Rodrigodp97/IOT01/PCB/WhatsApp Image 2025-04-30 at 15.31.54.jpeg

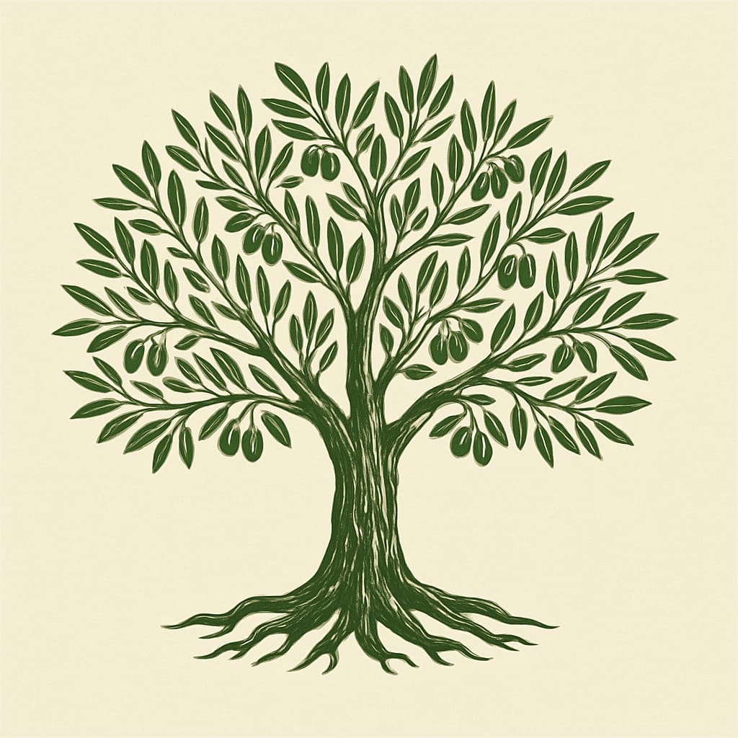
PCB/WhatsApp Image 2025-04-30 at 15.31.54.jpeg
