Rodrigodp97/IOT01/PCB/WhatsApp Image 2025-04-29 at 13.22.06.jpeg

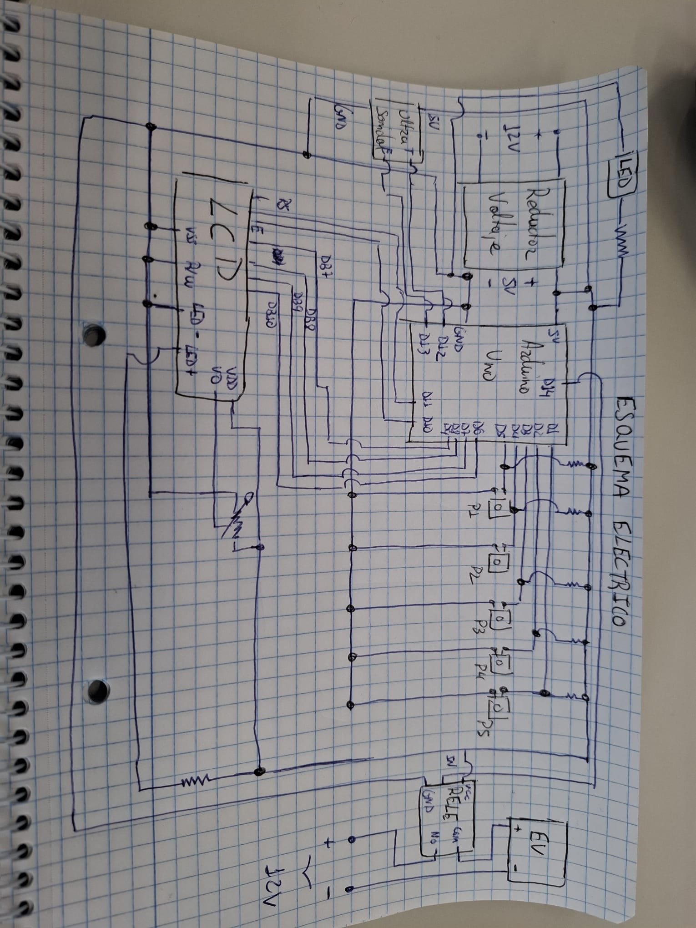
PCB/WhatsApp Image 2025-04-29 at 13.22.06.jpeg
