Rodrigodp97/IOT01/GUI/assets/images/93916a4476.png

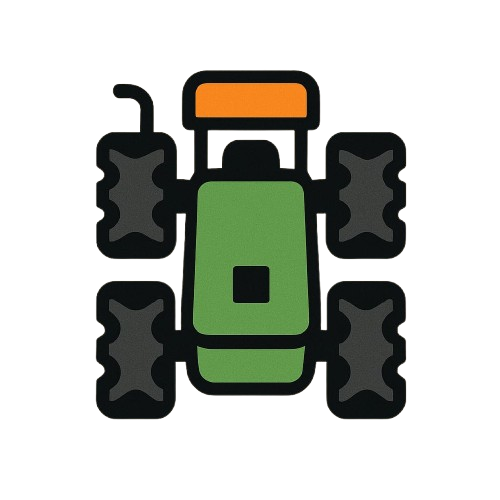
GUI/assets/images/93916a4476.png
