Rodrigodp97/IOT01/PCB/Prueba_Fumigador1.kicad_pcb

## KiCad design PCB/Prueba_Fumigador1.kicad_pcb (2025-07-09)

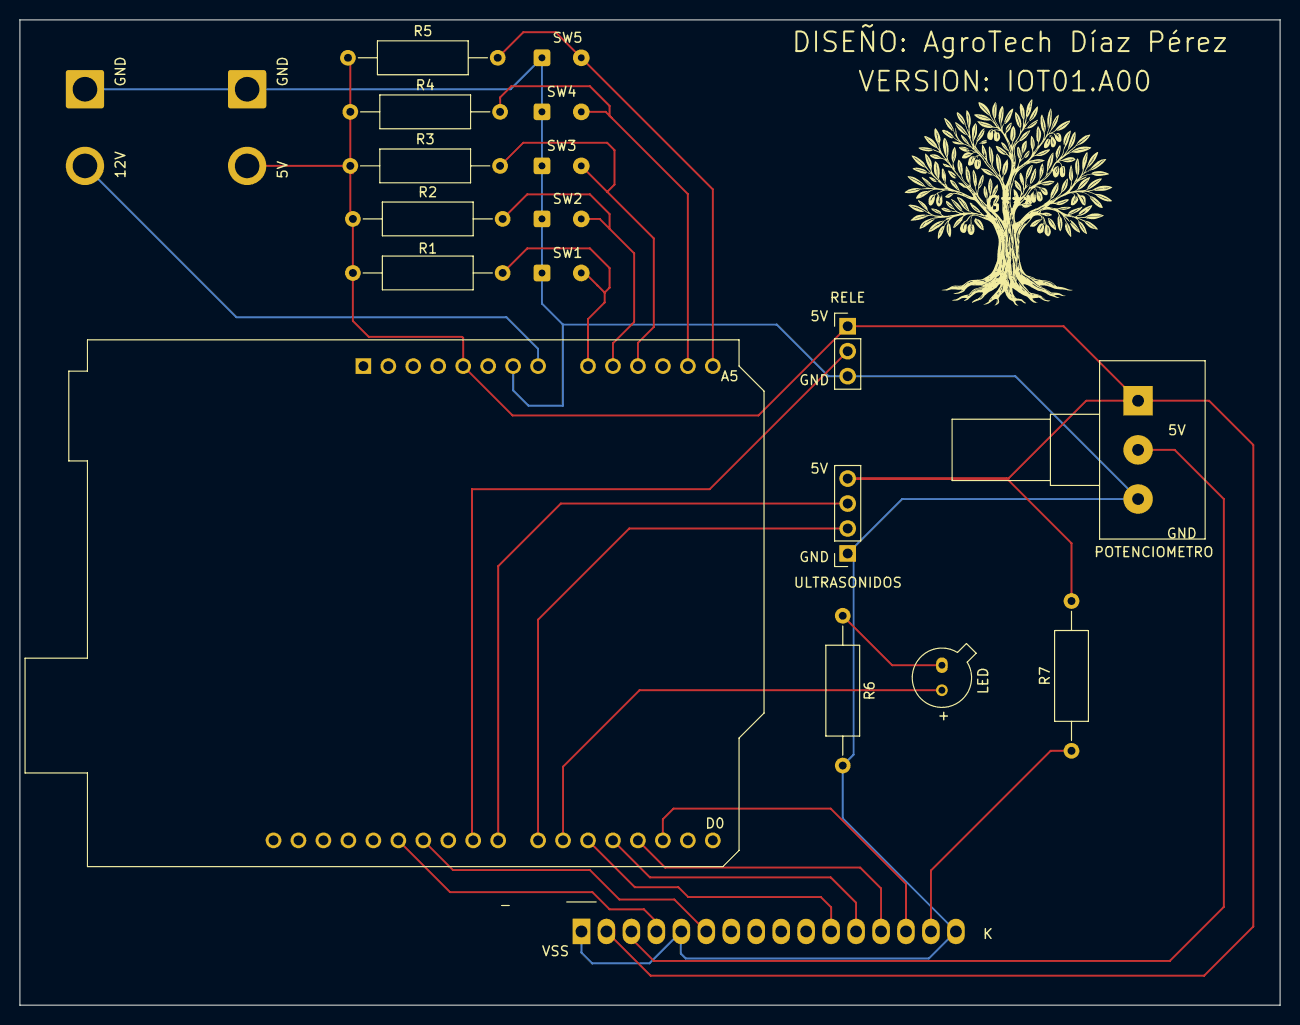
[picture p6: board Prueba_Fumigador1.kicad_pcb from above]

Board: 2 copper layers, 128.2 x 100.2 mm, 20 parts (0 on the bottom side), 21 nets.

Parts:
12V: Conn_01x02; SolderWire-2sqmm_1x02_P7.8mm_D2mm_OD3.9mm
A5: Arduino_UNO_R3
D1: SFH460; TO-18-2_Window
DS1: WC1602A
GND: Conn_01x02; SolderWire-2sqmm_1x02_P7.8mm_D2mm_OD3.9mm
POTENCIOMETRO: R_Potentiometer; Potentiometer_Alps_RK163_Single_Horizontal
R1, R2, R3, R4, R5: 5k; R_Axial_DIN0309_L9.0mm_D3.2mm_P15.24mm_Horizontal
R6, R7: 200; R_Axial_DIN0309_L9.0mm_D3.2mm_P15.24mm_Horizontal
RELE: Conn_01x03_Pin; PinHeader_1x03_P2.54mm_Vertical
SW1: BOTON ARRIBA; SolderWire-0.15sqmm_1x02_P4mm_D0.5mm_OD1.5mm
SW2: BOTON ABAJO; SolderWire-0.15sqmm_1x02_P4mm_D0.5mm_OD1.5mm
SW3: BOTON OK; SolderWire-0.15sqmm_1x02_P4mm_D0.5mm_OD1.5mm
SW4: BOTON ESC; SolderWire-0.15sqmm_1x02_P4mm_D0.5mm_OD1.5mm
SW5: BOTON MANUAL; SolderWire-0.15sqmm_1x02_P4mm_D0.5mm_OD1.5mm
ULTRASONIDOS: Conn_01x04_Socket; PinSocket_1x04_P2.54mm_Vertical

Connections:
+5V: A5.5 (+5V), DS1.2 (VDD), GND.2, POTENCIOMETRO.1, R1.1, R2.1, R3.1, R4.1, R5.1, R7.2, RELE.1, ULTRASONIDOS.4
+12V: 12V.2, A5.8 (VIN)
A0: A5.9 (A0), R1.2, SW1.2
A1: A5.10 (A1), R2.2, SW2.2
A2: A5.11 (A2), R3.2, SW3.2
A4: A5.13 (SDA/A4), R4.2, SW4.2
A5: A5.14 (SCL/A5), R5.2, SW5.2
D2: A5.17 (D2), DS1.14 (D7)
D3: A5.18 (D3), DS1.13 (D6)
D4: A5.19 (D4), DS1.12 (D5)
D5: A5.20 (D5), DS1.11 (D4)
D6: A5.21 (D6), D1.2 (A)
D7: A5.22 (D7), ULTRASONIDOS.2
D8: A5.23 (D8), ULTRASONIDOS.3
D9: A5.24 (D9), RELE.2
D11: A5.26 (D11), DS1.6 (E)
D12: A5.27 (D12), DS1.4 (RS)
GND: 12V.1, A5.7 (GND), DS1.1 (VSS), DS1.5 (R/W), DS1.16 (LED(-)), GND.1, POTENCIOMETRO.3, R6.2, RELE.3, SW1.1, SW2.1, SW3.1, SW4.1, SW5.1, ULTRASONIDOS.1
unnamed: D1.1 (K), R6.1
unnamed: DS1.15 (LED(+)), R7.1
RPOT: DS1.3 (VO), POTENCIOMETRO.2
