Rodrigodp97/IOT01/(commit log)

2025-07-09 Proyecto KiCad de la PCB
    [Prueba_Fumigador1.kicad_pcb, Prueba_Fumigador1.kicad_sch, Prueba_Fumigador1_v2.kicad_pcb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]
2026-01-15 Script de python con inferaz grafica con camara y configuraciones
2026-01-15 Se actualiza el codigo para poder controlarse desde la interfaz grafica y se desactivan todos los botones
2026-01-15 Primera prueba raspberry pi
2026-01-15 Prueba raspberry pi exitosa
2026-01-16 Se añaden los archivos de la version A00
2026-01-16 Se añaden modificaciones en la version beta A01 del arduino y se incluye la interfaz gráfica para que corra en raspberry pi
2026-02-18 Mejoras con la inclusion de mapas
2026-02-18 Actualizacion codigo arduino
2026-02-19 Actualizar app.py para mostrar mejor la camara
2026-02-28 Pruebas envio ubicacion a traves de conexion WiFi
2026-02-28 Comunicacion exitosa en envio ubicacion entre movil y raspberry
2026-03-03 Obtencion y representacion en mapas de la ubicacion GPS del movil
